Roboy/roboy_crazyfly/roboy_crazyfly.kicad_pcb

## KiCad design roboy_crazyfly.kicad_pcb (2018-02-21)

Schematic: roboy_crazyfly.sch

Parts:
C1, C2, C3, C4, C7: 100n; C_0402
C5: 10n; C_0402
C6: 1u; C_0402
C8, C9: 4.7u; C_0402
D1, D2, D3, D4: BAT54; C_0402
D5, D6, D7, D8, D9: LED; LED_0603
P1: MICRO_B_USB; USB_Micro-B_Molex_47346-0001
P2: CONN_BAT; Socket_Strip_Straight_1x02
P3: CONN_01X06; Socket_Strip_Straight_1x06
P4: CONN_01X04; Socket_Strip_Straight_1x04
P5, P6: CONN_01X10; Socket_Strip_Straight_1x10
P7, P8, P9, P10: CONN_01X02; JST-2-pin-female-side
Q1, Q2, Q3, Q4: PMV30UN2; SOT-23
R1, R25, R26, R27, R28: 10k; R_0402
R2, R5, R8: 47; R_0402
R3, R7: 100; R_0402
R4, R6, R9, R10: 2.2k; R_0402
R29, R30, R31, R32: 100k; R_0402
U1: STM32F405; LQFP-64_10x10mm_Pitch0.5mm
U2: 24AA64FT-E/OT; SOT-23-5
Y1: Crystal; CRYSTAL_8MHZ

Connections:
+BATT: D1.1 (K), D2.1 (K), D3.1 (K), D4.1 (K), P2.1, P7.2, P8.2, P9.2, P10.2; also elsewhere on the board
/E_CS0: P5.9, U1.53
/E_CS1: P5.8, U1.56
/E_CS2: P5.7, U1.57
/E_CS3: P5.6, U1.61
/E_MISO: P6.4, U1.22
/E_MOSI: P6.5, U1.23
/E_NRF_IO1: P6.7
/E_NRF_IO2: P6.6
/E_OW/WKUP: P6.8
/E_RX1: P5.2, U1.52
/E_RX2: P6.2, U1.17
/E_SCK: P6.3, U1.21
/E_SCL: P5.5, R9.2, U1.58, U2.1 (scl)
/E_SDA: P5.4, R10.2, U1.59, U2.3 (sda)
/E_TX1: P5.3, U1.51
/E_TX2: P6.1, U1.16
/IMU_SCL: R6.2, U1.41; also elsewhere on the board
/IMU_SDA: R4.2, U1.40; also elsewhere on the board
/LED_BLUE_L: R2.1, U1.54
/LED_GREEN_L: R5.2, U1.9
/LED_GREEN_R: R8.2, U1.10
/LED_RED_L: R3.1, U1.8
/LED_RED_R: R7.2, U1.11
/MOTOR1: R29.2, U1.15
/MOTOR2: R30.2, U1.30
/MOTOR3: R31.2, U1.50
/MOTOR4: R32.2, U1.62
/MPU_FSYNC: U1.3; also elsewhere on the board
/MPU_INT: U1.2
/NRF_FLOW_CTRL: U1.20
/NRF_RX: U1.37
/NRF_SWCLK: P4.1, U1.34
/NRF_SWIO: P4.4, U1.36
/NRF_TX: U1.38
/STM_BOOT0: R1.1, U1.60
/STM_NRST: C7.1, P3.2, U1.7
/STM_STO: P3.1
/STM_SW0: U1.55
/STM_SWCLK: P3.5, U1.49
/STM_SWIO: P3.3, U1.46
/VUSB: P1.1, P6.10
/V_COM_EXP: P6.9
GDN: D5.1 (K)
GND: C1.2, C2.2, C3.2, C4.2, C5.2, C6.2, C7.2, C8.2, C9.2, P1.5, P2.2, P3.4, P4.3, P5.10, Q1.1 (S), Q2.1 (S), Q3.1 (S), Q4.1 (S), R1.2, R25.2, R26.2, R27.2, R28.2, U1.12, U1.18, U1.28, U1.63, U2.2 (VSS), U2.5 (wp); also elsewhere on the board
unnamed: C8.1, U1.31
unnamed: C9.1, U1.47
unnamed: D1.2 (A), P7.1, Q1.3 (D)
unnamed: D2.2 (A), P8.1, Q2.3 (D)
unnamed: D3.2 (A), P9.1, Q3.3 (D)
unnamed: D4.2 (A), P10.1, Q4.3 (D)
unnamed: D5.2 (A), R2.2
unnamed: D6.1 (K), R3.2
unnamed: D7.1 (K), R5.1
unnamed: D8.1 (K), R7.1
unnamed: D9.1 (K), R8.1
unnamed: P1.2, U1.44
unnamed: P1.3, U1.45
unnamed: P1.4, U1.43
unnamed: Q1.2 (G), R25.1, R29.1
unnamed: Q2.2 (G), R26.1, R30.1
unnamed: Q3.2 (G), R27.1, R31.1
unnamed: Q4.2 (G), R28.1, R32.1
unnamed: U1.5, Y1.1
unnamed: U1.6, Y1.2
VCC: C1.1, C2.1, C3.1, C4.1, C5.1, C6.1, D6.2 (A), D7.2 (A), D8.2 (A), D9.2 (A), P3.6, P5.1, R4.1, R6.1, R9.1, R10.1, U1.13, U1.19, U1.32, U1.48, U1.64, U2.4 (vcc); also elsewhere on the board
VCCNRF: P4.2, U1.1; also elsewhere on the board

Notes on the sheet:
I2C address 1010000b
U1 decoupling: 100n on each VDD 10n and 4.7u on VDDA

Schematic: imu.sch

Parts:
C10, C13, C14: 100n; C_0402
C11: 4.7u; C_0402
C12: 10n; C_0402
U3: MPU9250; mpu9250
U4: LPS25H

Connections:
/IMU_SCL: U3.23; also elsewhere on the board
/IMU_SDA: U3.24; also elsewhere on the board
/MPU_FSYNC: U3.11; also elsewhere on the board
GND: C10.2, C11.2, C12.2, C13.2, C14.2, U3.18, U3.20, U4.3, U4.8, U4.9; also elsewhere on the board
unnamed: U3.7, U4.2
unnamed: U3.21, U4.4
VCCA: C10.1, C11.1, C12.1, C13.1, C14.1, U3.1, U3.8, U3.9, U3.10, U3.13, U3.22, U4.1, U4.5, U4.6, U4.10; also elsewhere on the board

Notes on the sheet:
I2C address 1101001b
I2C address 1011101b

Schematic: pm_radio.sch

Parts:
C15, C26, C31, C32, C34: 4.7u; C_0402
C16, C17, C18, C19, C22: 100n; C_0402
C20: 22uF; 22uF-elektrolyt-kondensator
C21: 47n; C_0402
C23: 2.2n; C_0402
C24, C35: 1u; C_0402
C25, C30: 12p; C_0402
C27, C29: 10n; C_0402
C28: 220p; C_0402
C33: 2.2p; C_0402
D10: LED; LED_0603
L1: 1uH; C_0402
L2: 1nH; C_0402
L3: 3.9nH; C_0402
R11: 200k; R_0402
R12, R13, R18, R20: 10k; R_0402
R14: 47; R_0402
R15, R17, R19, R21, R22, R24: 1k; R_0402
R16: 100k; R_0402
R23: 0; R_0402
SW1: SW_PUSH; switch_tactile
U5: NRF51822; UQFN-48-1EP_6x6mm_Pitch0.4mm
U6: BQ24075; QFN-16-1EP_3x3mm_Pitch0.5mm
U7: BALUN; BALUN_WIFI_BLUETOOTH
U8: NCP702SN30; TSOP-5_1.65x3.05mm_Pitch0.95mm
U9: LP2985-30; SOT-23-5
U10: SiP32431; SC-70-6
U11: RFX2401C; QFN-16-1EP_3x3mm_Pitch0.5mm
U12: antenna; RF_ANTENNA
U13: TSX-3225; SMD_CRYSTALL_TSX-3225

Connections:
+BATT: C20.1, R11.2, U6.2, U6.3; also elsewhere on the board
/pm_radio/ANT+: U5.31, U7.4
/pm_radio/ANT-: U5.32, U7.3
/pm_radio/E_NRF_IO1: U5.18
/pm_radio/E_NRF_IO2: U5.17
/pm_radio/E_OW/WKUP: R15.2, U5.14
/pm_radio/LED_BLUE: R14.2, U5.19
/pm_radio/NRF_FLOW_CTRL: U5.20
/pm_radio/NRF_RX: U5.3
/pm_radio/NRF_SWCLK: U5.24
/pm_radio/NRF_SWIO: U5.23
/pm_radio/NRF_TX: U5.48
/pm_radio/OW_PU: R15.1, U5.15
/pm_radio/PA_RX_EN: R21.1
/pm_radio/PA_TX_DIS: U5.28
/pm_radio/PM_CHG: U5.4, U6.9
/pm_radio/PM_CHG_EN: U5.11, U6.4
/pm_radio/PM_EN1: U5.9, U6.6
/pm_radio/PM_EN2: U5.10, U6.5
/pm_radio/PM_ISET: R19.1, U5.7, U6.16
/pm_radio/PM_PGOOD: U5.8, U6.7
/pm_radio/STM_BOOT0: U5.41
/pm_radio/STM_NRST: U5.40
/pm_radio/STM_SWCLK: U5.47
/pm_radio/STM_SWIO: R22.1, U5.43
/pm_radio/SWITCH: SW1.1, U5.25
/pm_radio/VBAT: C19.2, R11.1, R16.2, U5.5
/pm_radio/VBAT_SINK: C19.1, R16.1, U5.6
/pm_radio/VCOM_EXP: U10.1
/pm_radio/VEN_D: R12.2, R13.1, U5.16, U9.3, U10.4
/pm_radio/VUSB: C15.1, R12.1, U6.13
GND: C15.2, C20.2, C21.2, C22.2, C23.2, C24.2, C25.2, C26.2, C27.2, C28.2, C29.2, C30.2, C31.2, C32.2, C34.2, C35.2, D10.1 (K), L2.2, R13.2, R17.2, R18.2, R19.2, R20.2, SW1.2, U5.13, U5.33, U5.34, U5.49, U6.8, U6.15, U6.17, U7.5, U8.2, U9.2, U10.2, U11.1, U11.2, U11.3, U11.7, U11.8, U11.9, U11.11, U11.12, U11.15, U11.17, U13.2 (GND), U13.4 (GND); also elsewhere on the board
unnamed: C16.2, C17.2, C18.2
unnamed: C21.1, U5.29
unnamed: C22.1, U5.39
unnamed: C23.1, R24.2, U5.30, U7.2
unnamed: C25.1, U5.37, U13.1 (OSC1)
unnamed: C29.1, U9.4
unnamed: C30.1, U5.38, U13.3 (OSC2)
unnamed: C33.1, L2.1, L3.2
unnamed: C33.2, U11.10
unnamed: D10.2 (A), R14.1
unnamed: L3.1, U12.1
unnamed: R17.1, U6.12
unnamed: R18.1, U6.14
unnamed: R20.1, U6.1
unnamed: R21.2, U5.27
unnamed: R22.2, U5.44
unnamed: R24.1, U11.5
unnamed: U7.1, U11.4
VCC: C31.1, L1.1, U9.5; also elsewhere on the board
VCCA: C32.1, L1.2; also elsewhere on the board
VCCNRF: C16.1, C17.1, C18.1, C26.1, C27.1, C28.1, C35.1, U5.1, U5.12, U5.35, U5.36, U8.5, U11.14, U11.16; also elsewhere on the board
VCOM: C24.1, C34.1, U6.10, U8.1, U8.3, U9.1, U10.3

Notes on the sheet:
Fast charge: 0.98A Input current limit: 1.55A
Filter the power supply at 73kHz should filter most of the PWM L1 shall support at least 20mA to power the IMU
Analog power only used by IMU. Inductance and capacitor placed near IMU

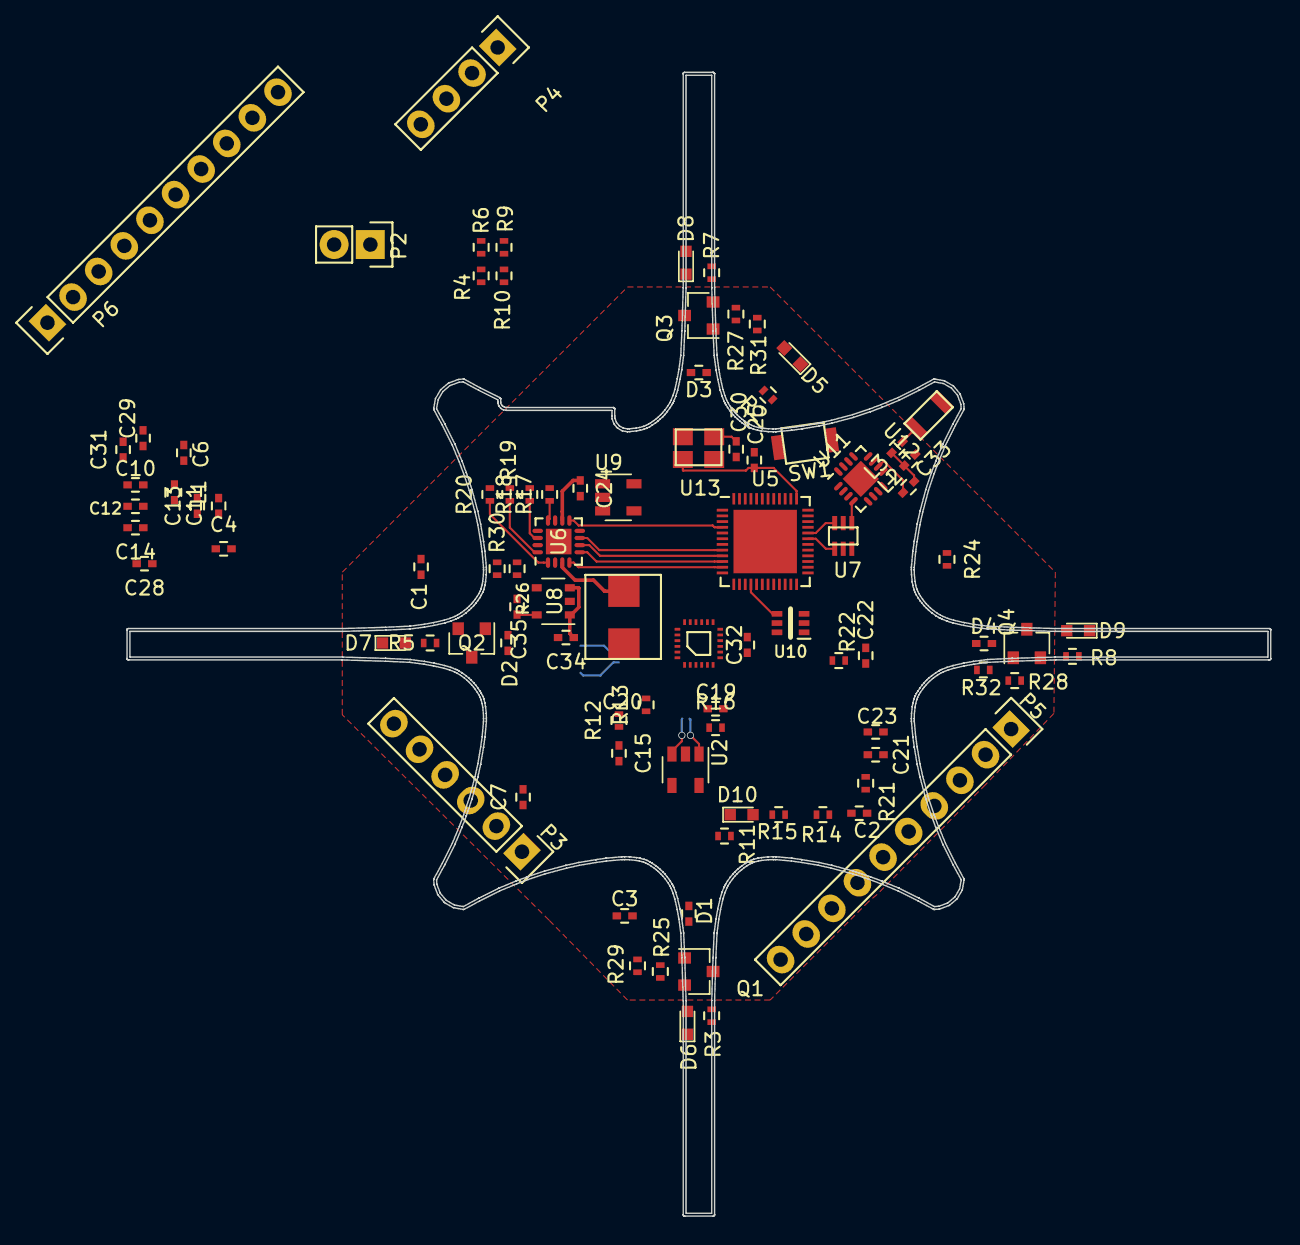
[picture p1: board roboy_crazyfly.kicad_pcb from above]

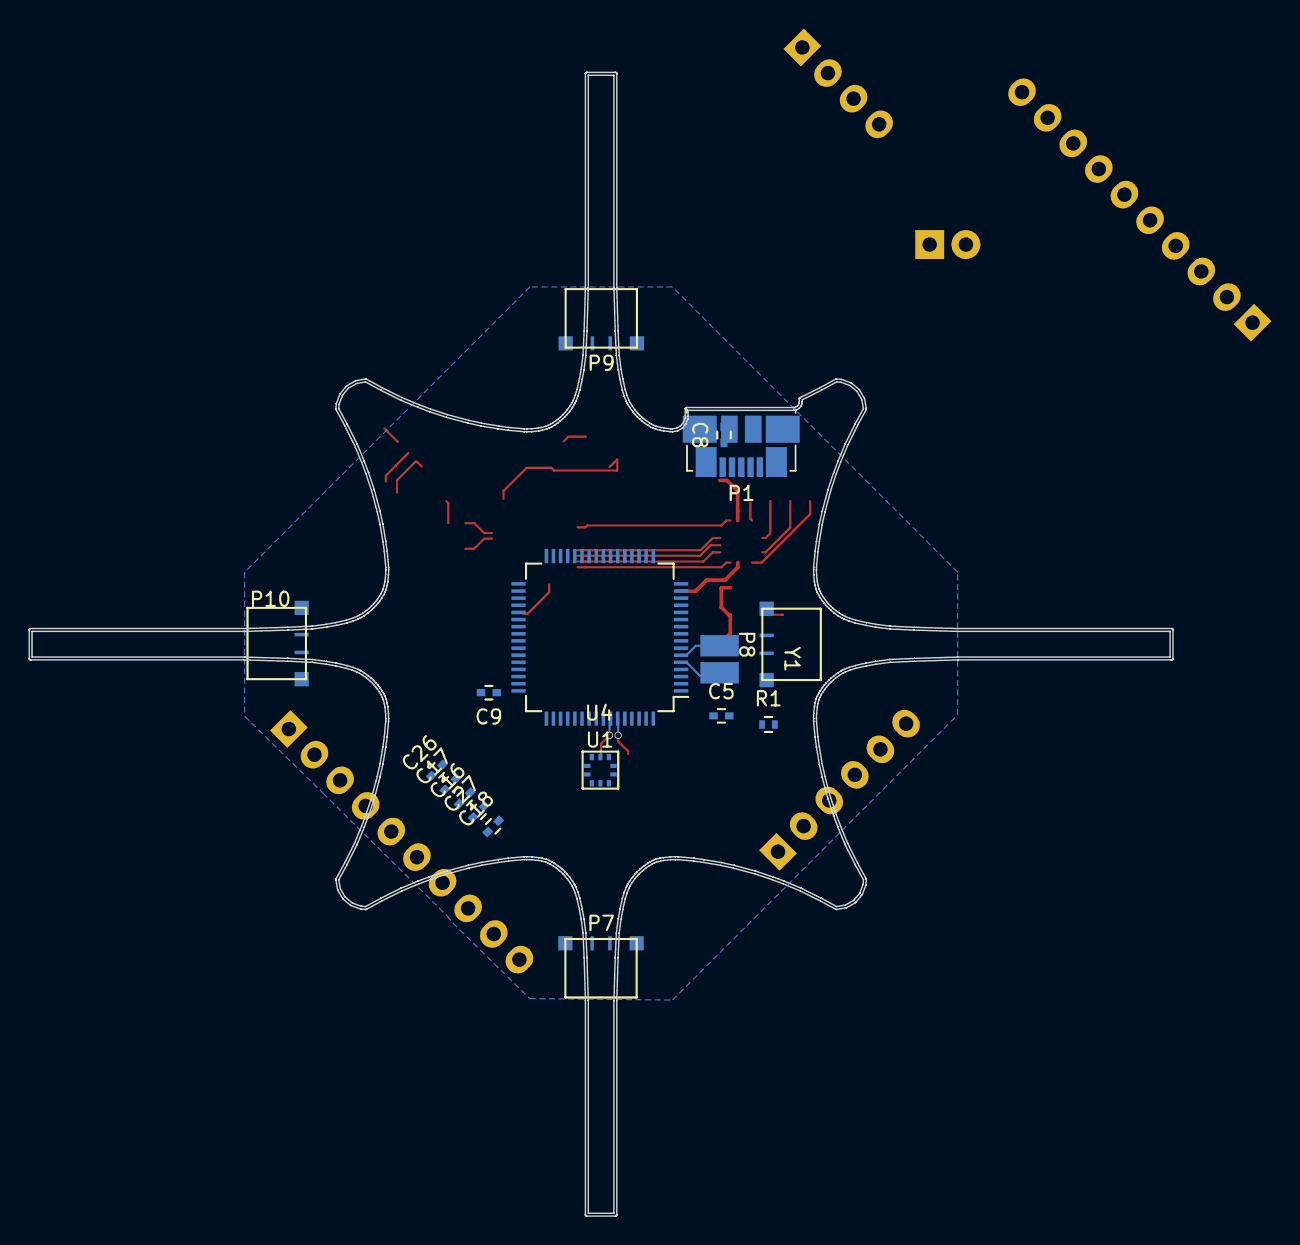
[picture p2: board roboy_crazyfly.kicad_pcb from below]

Board: 4 copper layers, 80.2 x 80.2 mm, 108 parts (17 on the bottom side), 95 nets.
