Roboy/roboy_crazyfly/(commit log)

2018-02-15 microcontoller schematics
    [imu.sch, pm_radio.sch, roboy_crazyfly.kicad_pcb, roboy_crazyfly.sch]
2018-02-15 almost done with schematics
    [BOM.csv, imu.sch, pm_radio.sch, roboy_crazyfly.sch]
2018-02-18 done with pcb outline
    [BOM.csv, _saved_roboy_crazyfly.sch, imu.sch, pm_radio.sch, roboy_crazyfly.kicad_pcb, roboy_crazyfly.sch]
2018-02-18 with correct footprints
    [imu-2018-02-18-12-42-59.sch, imu.sch, pm_radio-2018-02-18-12-42-59.sch, pm_radio.sch, roboy_crazyfly-2018-02-18-12-42-59.sch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]
2018-02-18 moved micro usb to side
    [roboy_crazyfly.kicad_pcb]
2018-02-18 added 22uF elektorlyt condensator
    [pm_radio.sch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]
2018-02-18 with current BOM
    [BOM.csv]
